GaryDyr/load_cell-streaming-ESP32/wt_time.png

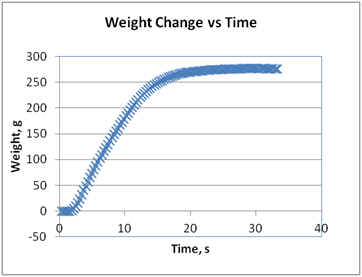
wt_time.png
